KryptonPlusPlus/bss500-sheldon-reverse/hardware/bss500ap/exports/pcb_top.jpg

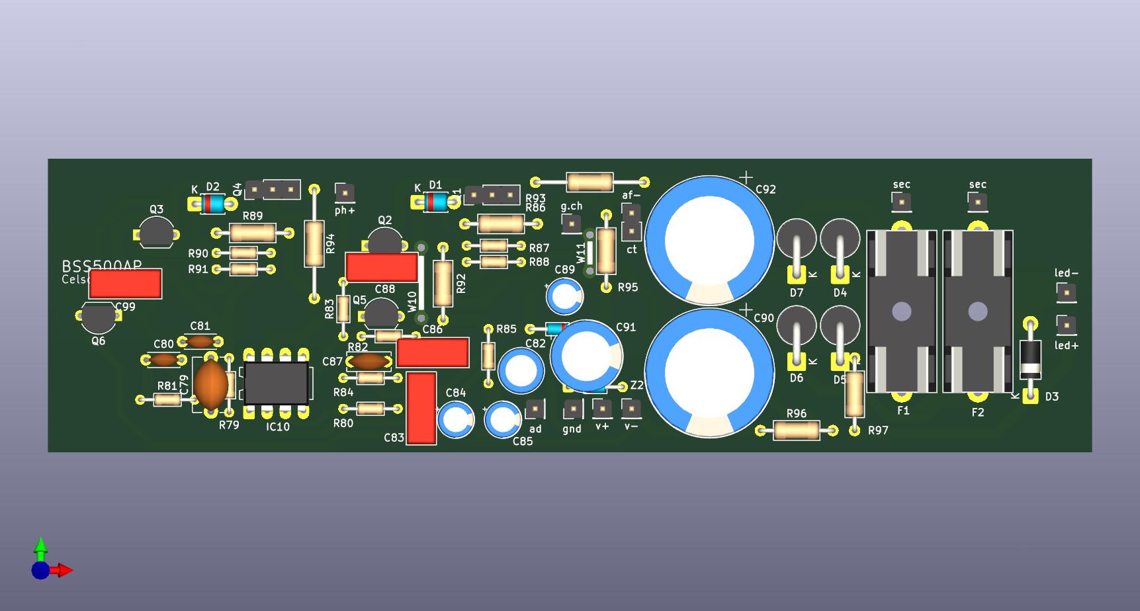
hardware/bss500ap/exports/pcb_top.jpg
