KryptonPlusPlus/bss500-sheldon-reverse/hardware/bss500ap/exports/pcb_bottom.jpg

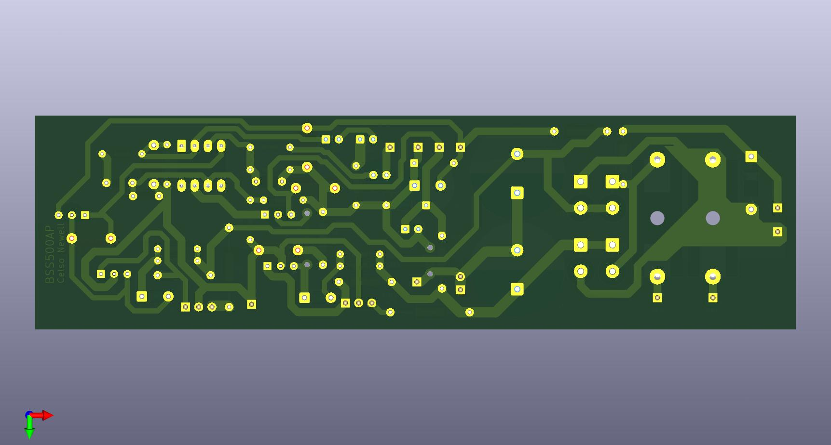
hardware/bss500ap/exports/pcb_bottom.jpg
