KryptonPlusPlus/bss500-sheldon-reverse/readme.md

# Sheldon BSS500 — Reverse Engineering

Engenharia reversa do amplificador de áudio **Sheldon BSS500**, com o objetivo de reconstruir seu circuito, documentar seus componentes e explorar possíveis modificações e melhorias.

> [!WARNING]
> **Atenção:** As informações deste repositório são baseadas na análise de um amplificador que aparenta ter passado por manutenções ou modificações anteriores. Portanto, alguns valores de componentes e conexões podem diferir do projeto original de fábrica. As informações documentadas são preliminares e devem ser verificadas antes de qualquer reprodução ou montagem do circuito.

## Objetivos

- Reconstruir o esquemático eletrônico a partir do equipamento físico.
- Identificar e documentar os componentes utilizados.
- Registrar as conexões e o funcionamento dos estágios do amplificador.
- Investigar possíveis modificações e melhorias no circuito.
- Documentar as alterações realizadas e seus efeitos no funcionamento do equipamento.

## Modificações e melhorias

Além da reconstrução do circuito, o projeto poderá incluir modificações com fins de estudo, aprimoramento e experimentação.

As possíveis alterações serão avaliadas conforme o avanço da análise do circuito original, considerando aspectos como desempenho, estabilidade, confiabilidade e qualidade de áudio.

## Status do projeto

O projeto está em desenvolvimento. A reconstrução do esquemático, a identificação dos componentes e a avaliação de possíveis modificações serão realizadas progressivamente.

## Disclaimer

Este é um projeto independente de engenharia reversa, desenvolvido para fins de estudo, experimentação e documentação. Não se trata de documentação oficial do fabricante Sheldon.
