KryptonPlusPlus/bss500-sheldon-reverse/references/pictures/bss500ap_pcb_top_side.jpeg

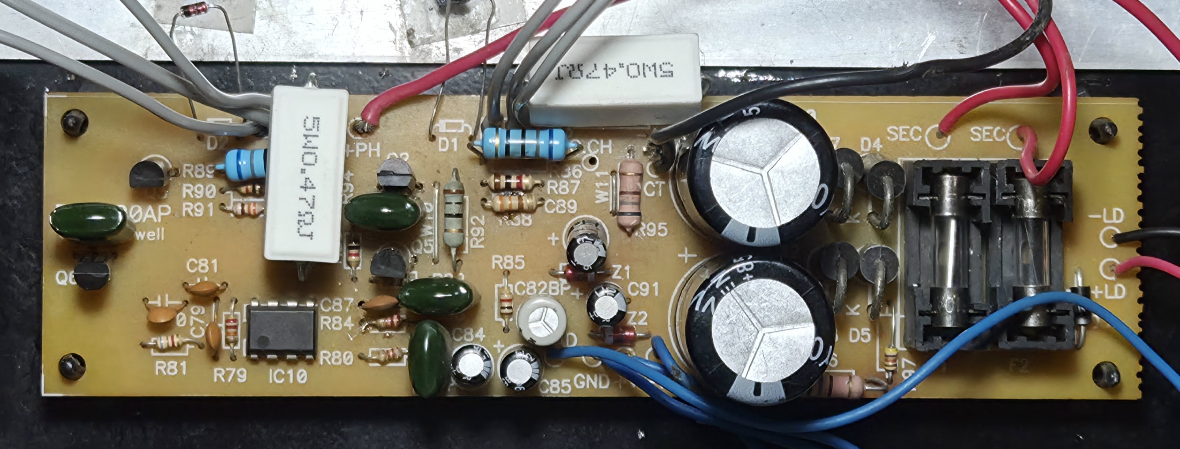
references/pictures/bss500ap_pcb_top_side.jpeg
