KryptonPlusPlus/bss500-sheldon-reverse/hardware/bss500ap/exports/pcb_layout.pdf

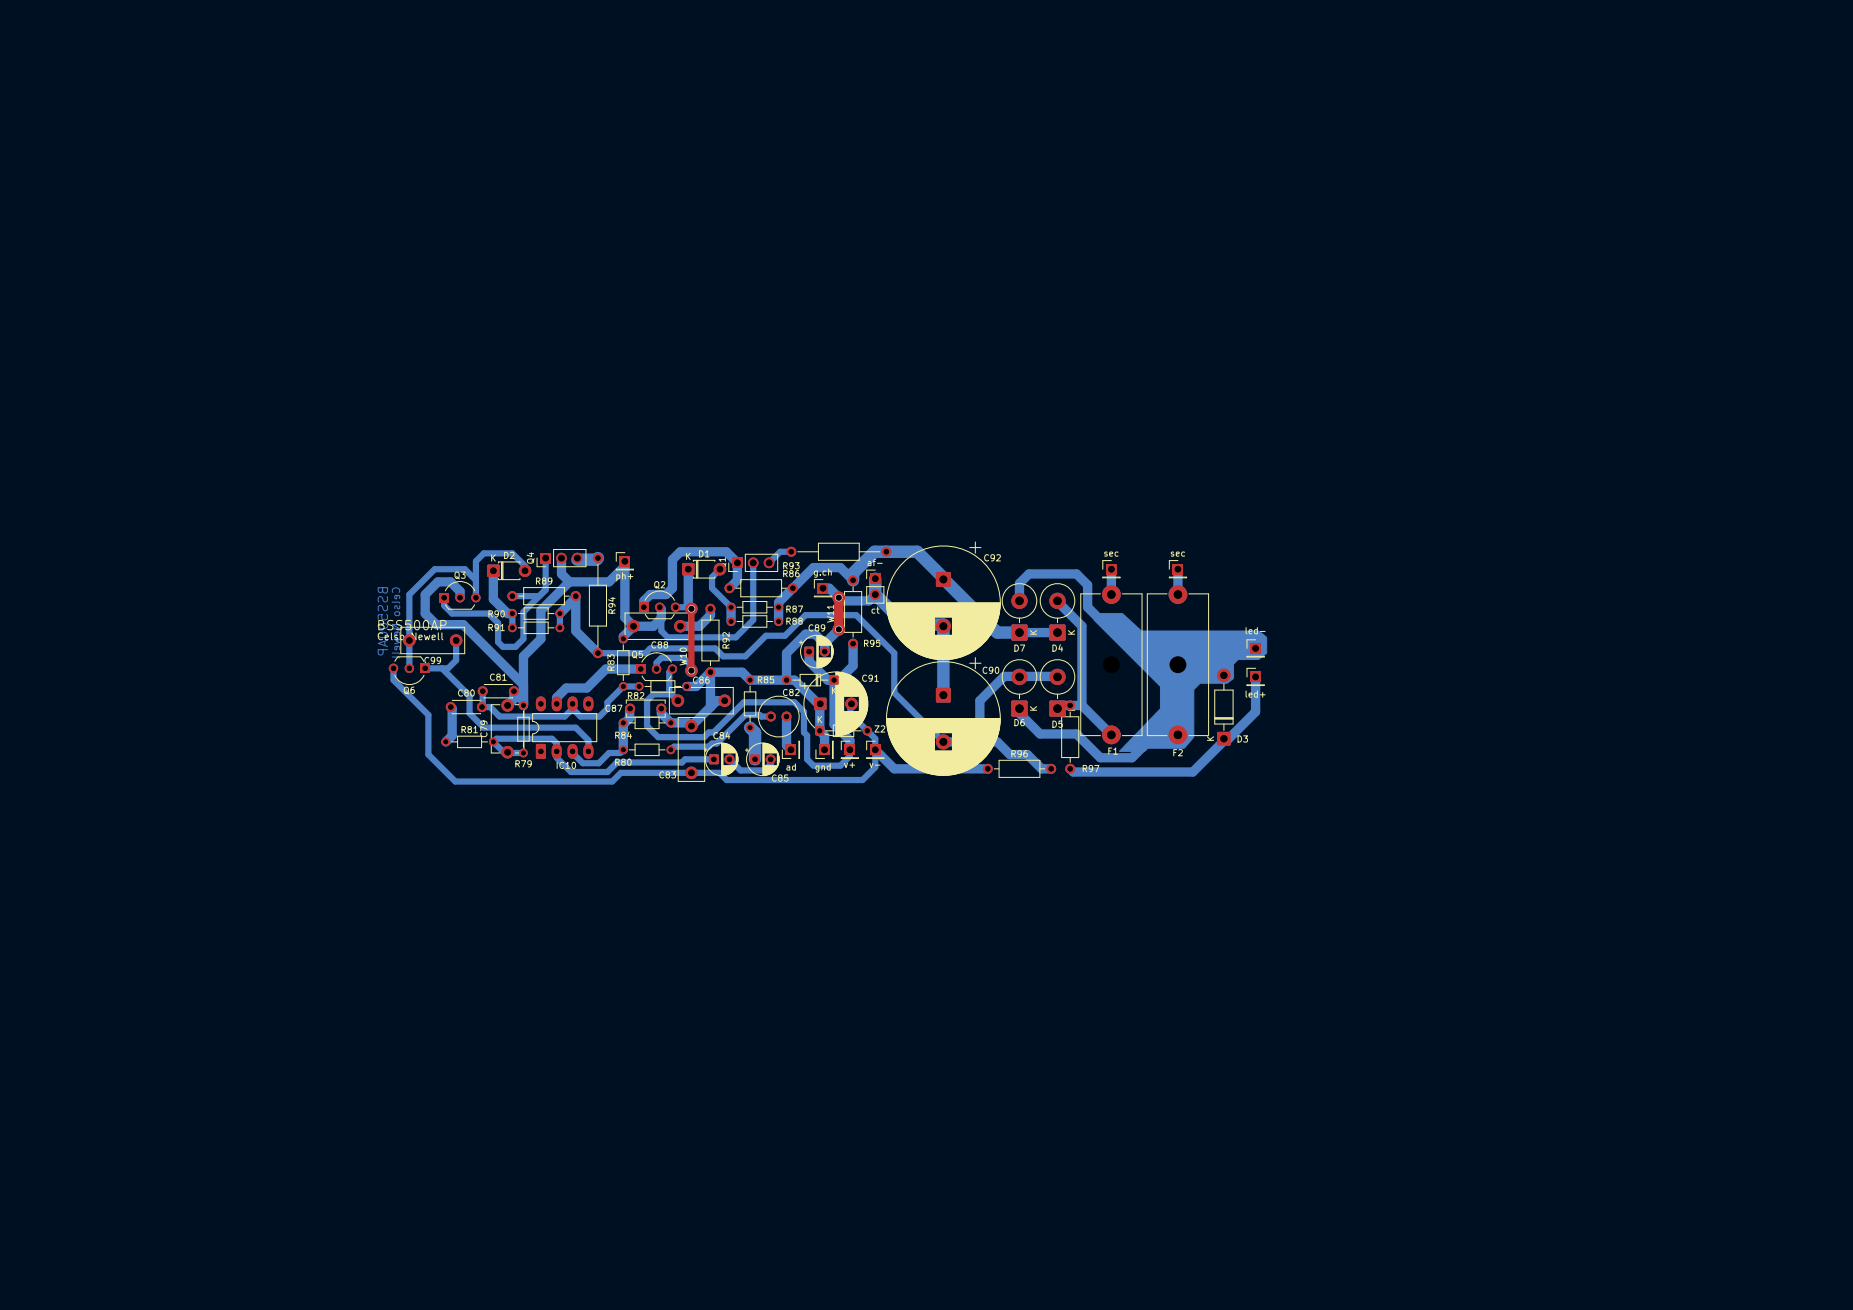
[picture p5: page 1]
