KryptonPlusPlus/bss500-sheldon-reverse/hardware/bss500ap/exports/schematic.pdf

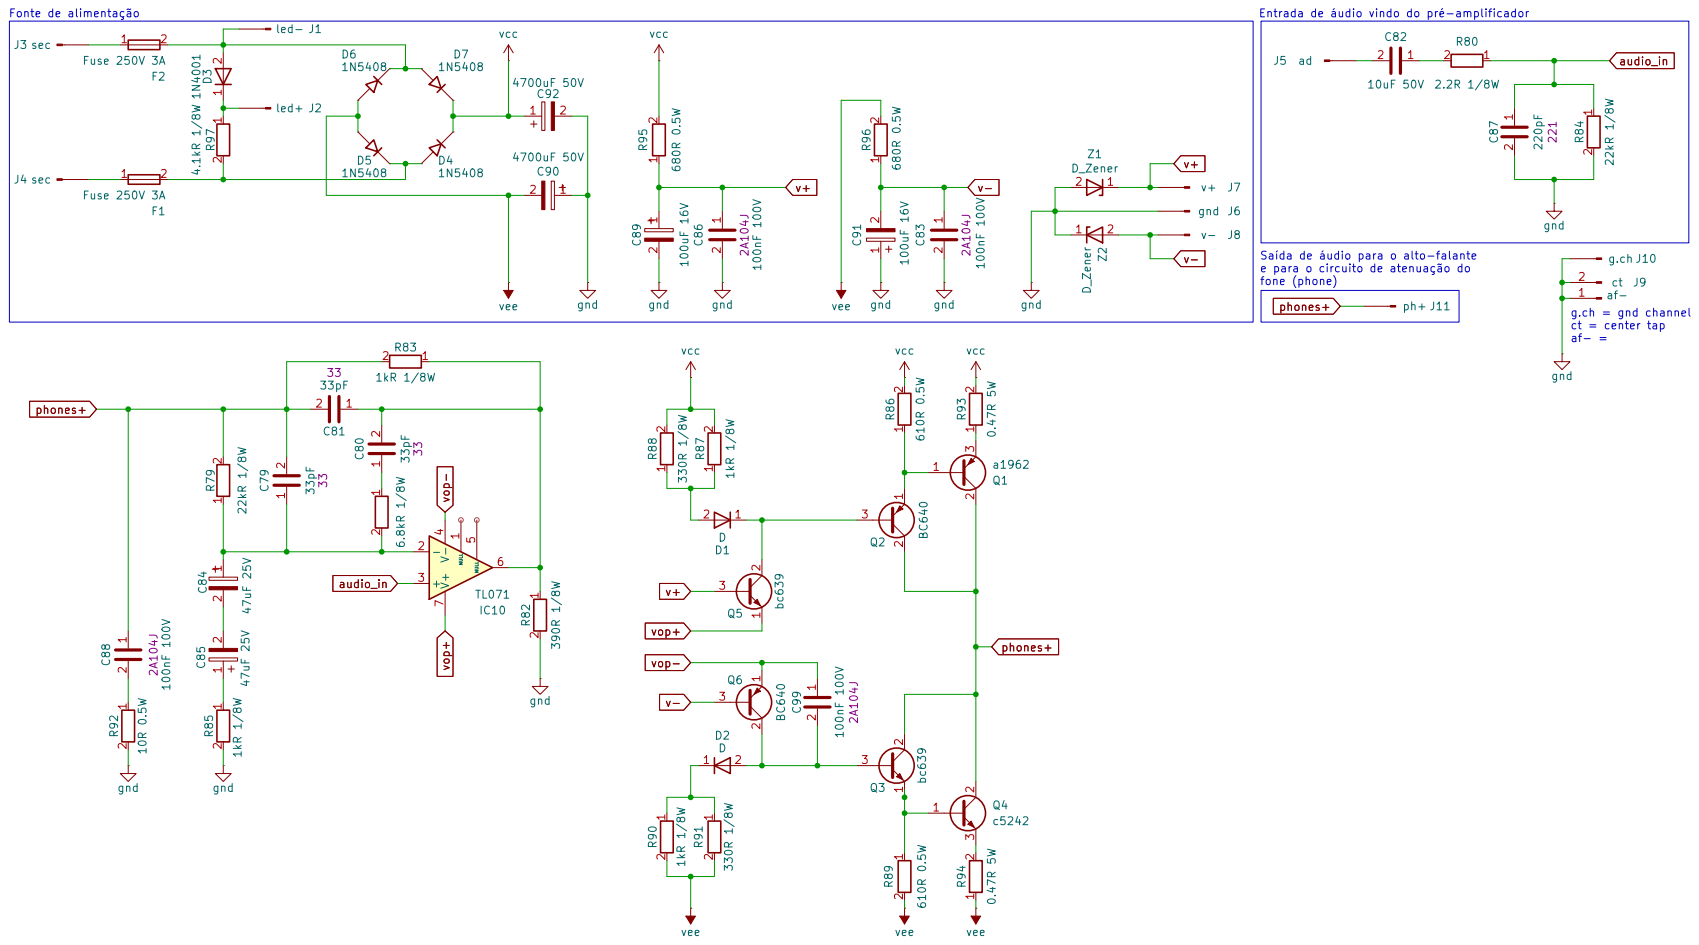
[picture p6: page 1]
