KryptonPlusPlus/bss500-sheldon-reverse/hardware/bss500ap/bss500ap.kicad_pcb

## KiCad design hardware/bss500ap/bss500ap.kicad_pcb (2026-10-28)

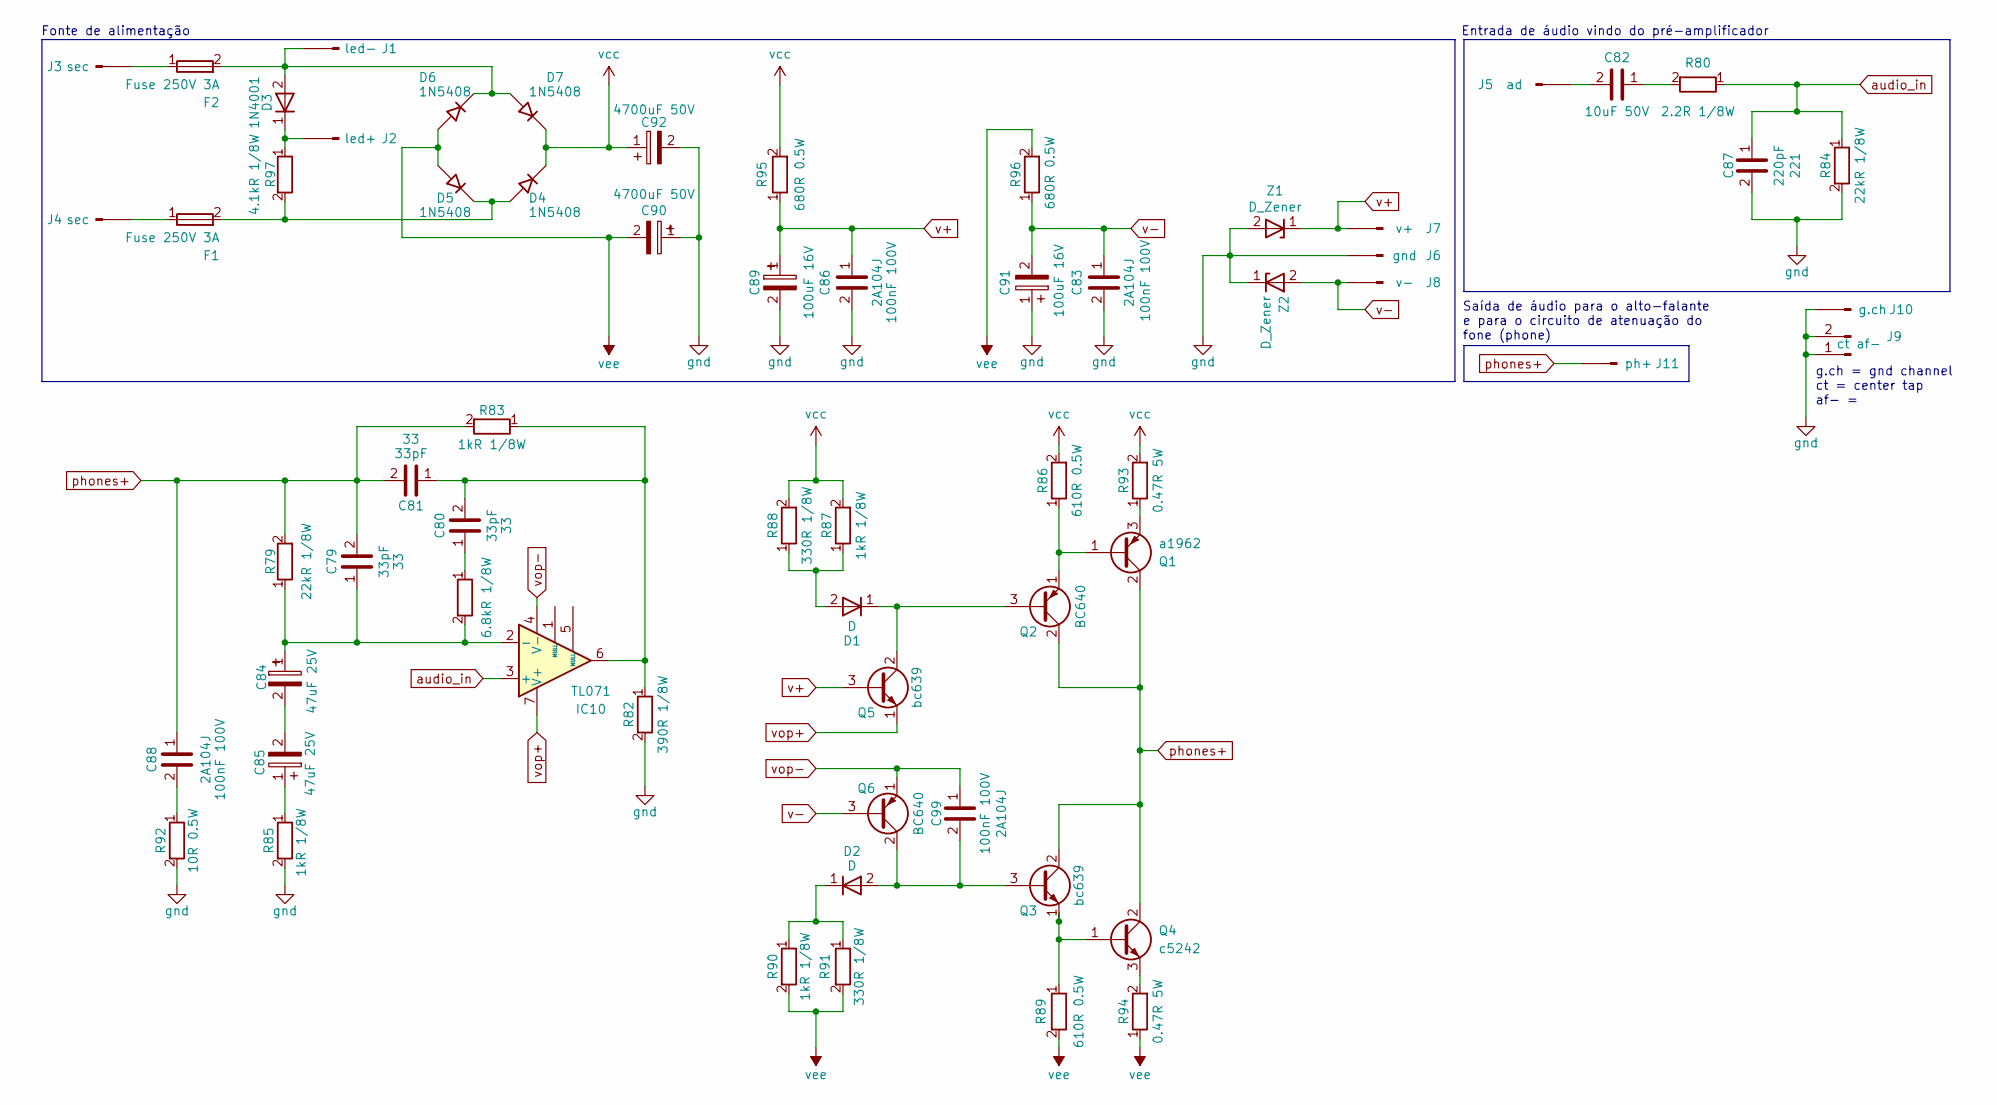
[picture p7: schematic bss500ap.kicad_sch]

Parts:
C79: 33pF; C_Disc_D7.5mm_W5.0mm_P7.50mm
C80, C81: 33pF; C_Disc_D4.3mm_W1.9mm_P5.00mm
C82: 10uF 50V; C_Radial_D6.3mm_H11.0mm_P2.50mm
C83, C86, C88, C99: 100nF 100V; C_Rect_L10.0mm_W4.0mm_P7.50mm_MKS4
C84, C85: 47uF 25V; CP_Radial_D5.0mm_P2.50mm
C87: 220pF; C_Disc_D6.0mm_W2.5mm_P5.00mm
C89: 100uF 16V; CP_Radial_D5.0mm_P2.50mm
C90, C92: 4700uF 50V; CP_Radial_D18.0mm_P7.50mm
C91: 100uF 16V; CP_Radial_D10.0mm_P5.00mm
D1, D2: D; D_T-1_P5.08mm_Horizontal
D3: 1N4001; D_DO-41_SOD81_P10.16mm_Horizontal
D4, D5, D6, D7: 1N5408; D_DO-201AE_P5.08mm_Vertical_KathodeUp
F1, F2: Fuse 250V 3A; Fuseholder_Cylinder-5x20mm_Schurter_0031_8201_Horizontal_Op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
IC10: TL071; DIP-8_W7.62mm_LongPads
J1: led-; PinHeader_1x01_P2.54mm_Vertical
J2: led+; PinHeader_1x01_P2.54mm_Vertical
J3, J4: sec; PinHeader_1x01_P2.54mm_Vertical
J5: ad; PinHeader_1x01_P2.54mm_Vertical
J6: gnd; PinHeader_1x01_P2.54mm_Vertical
J7: v+; PinHeader_1x01_P2.54mm_Vertical
J8: v-; PinHeader_1x01_P2.54mm_Vertical
J9: ct af-; PinHeader_1x02_P2.54mm_Vertical
J10: g.ch; PinHeader_1x01_P2.54mm_Vertical
J11: ph+; PinHeader_1x01_P2.54mm_Vertical
Q1: a1962; PinHeader_1x03_P2.54mm_Vertical
Q2, Q6: BC640; TO-92_Inline_Wide
Q3, Q5: bc639; TO-92_Inline_Wide
Q4: c5242; PinHeader_1x03_P2.54mm_Vertical
R79, R84: 22kR 1/8W; R_Axial_DIN0204_L3.6mm_D1.6mm_P7.62mm_Horizontal
R80: 2.2R 1/8W; R_Axial_DIN0204_L3.6mm_D1.6mm_P7.62mm_Horizontal
R81: 6.8kR 1/8W; R_Axial_DIN0204_L3.6mm_D1.6mm_P7.62mm_Horizontal
R82: 390R 1/8W; R_Axial_DIN0204_L3.6mm_D1.6mm_P7.62mm_Horizontal
R83, R85, R87, R90: 1kR 1/8W; R_Axial_DIN0204_L3.6mm_D1.6mm_P7.62mm_Horizontal
R86, R89: 610R 0.5W; R_Axial_DIN0207_L6.3mm_D2.5mm_P10.16mm_Horizontal
R88, R91: 330R 1/8W; R_Axial_DIN0204_L3.6mm_D1.6mm_P7.62mm_Horizontal
R92: 10R 0.5W; R_Axial_DIN0207_L6.3mm_D2.5mm_P10.16mm_Horizontal
R93, R94: 0.47R 5W; R_Axial_DIN0207_L6.3mm_D2.5mm_P15.24mm_Horizontal
R95, R96: 680R 0.5W; R_Axial_DIN0207_L6.3mm_D2.5mm_P10.16mm_Horizontal
R97: 4.1kR 1/8W; R_Axial_DIN0207_L6.3mm_D2.5mm_P10.16mm_Horizontal
Z1, Z2: D_Zener; D_DO-34_SOD68_P7.62mm_Horizontal

Connections:
unnamed: C80.1, R81.1
unnamed: C80.2, C81.1, IC10.6, R82.1, R83.1
unnamed: C82.1, R80.2
unnamed: C84.2, C85.2
unnamed: C85.1, R85.1
unnamed: C88.2, R92.1
unnamed: D1.2 (A), R87.1, R88.1
unnamed: D1.1 (K), Q2.3 (B), Q5.2 (C)
unnamed: C99.2, D2.2 (A), Q3.3 (B), Q6.2 (C)
unnamed: D2.1 (K), R90.1, R91.1
unnamed: D3.2 (A), D6.1 (K), D7.2 (A), F2.2, J1.1
unnamed: D3.1 (K), J2.1, R97.1
unnamed: D4.2 (A), D5.1 (K), F1.2, R97.2
unnamed: C79.1, C84.1, IC10.2 (-), R79.1, R81.2
unnamed: F2.1, J3.1
unnamed: F1.1, J4.1
unnamed: C82.2, J5.1
unnamed: Q1.1 (B), Q2.1 (E), R86.1
unnamed: Q1.3 (E), R93.1
unnamed: Q3.1 (E), Q4.1 (B), R89.1
unnamed: Q4.3 (E), R94.2
audio_in: C87.1, IC10.3 (+), R80.1, R84.1
gnd: C83.2, C86.2, C87.2, C89.2, C90.1, C91.1, C92.2, J6.1, J9.1, J9.2, J10.1, R82.2, R84.2, R85.2, R92.2, Z1.2 (A), Z2.1 (K)
phones+: C79.2, C81.2, C88.1, J11.1, Q1.2 (C), Q2.2 (C), Q3.2 (C), Q4.2 (C), R79.2, R83.2
v+: C86.1, C89.1, J7.1, Q5.3 (B), R95.1, Z1.1 (K)
v-: C83.1, C91.2, J8.1, Q6.3 (B), R96.1, Z2.2 (A)
vcc: C92.1, D4.1 (K), D7.1 (K), R86.2, R87.2, R88.2, R93.2, R95.2
vee: C90.2, D5.2 (A), D6.2 (A), R89.2, R90.2, R91.2, R94.1, R96.2
vop+: IC10.7 (V+), Q5.1 (E)
vop-: C99.1, IC10.4 (V-), Q6.1 (E)

Notes on the sheet:
Entrada de áudio vindo do pré-amplificador
Saída de áudio para o alto-falante e para o circuito de atenuação do fone (phone)
Fonte de alimentação
g.ch = gnd channel ct = center tap af- =

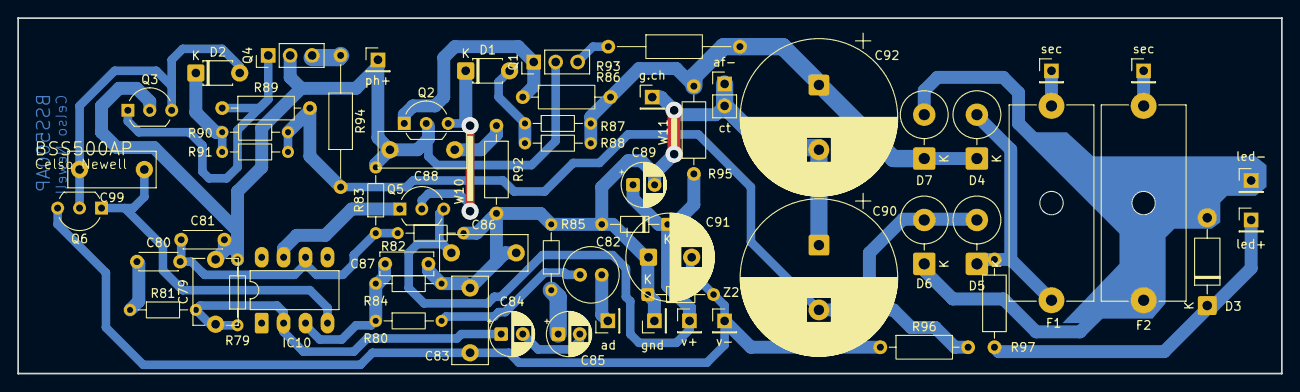
[picture p8: board bss500ap.kicad_pcb from above]

Board: 2 copper layers, 146.3 x 41.1 mm, 63 parts (0 on the bottom side), 30 nets.
