KryptonPlusPlus/bss500-sheldon-reverse/(commit log)

2026-10-28 docs(references/pictures): adiciona fotos da PCB do amplificador
2026-10-28 docs: adiciona lista de componentes da PCB do amplificador
    Adiciona a lista de componenets inicial.
    Alguns componentes ainda precisam ser identificados e
    ter seus valores e footprints confirmados.
2026-10-28 docs: adiciona diário de reparos da placa de potência
    Documenta a inspeção visual, as medições iniciais, os testes de acionamento e os sintomas observados após as intervenções.
    Registra componentes com possíveis falhas e medições que ainda precisam ser confirmadas.
2026-10-28 feat(hardware/bss500ap): adiciona projeto KiCad da placa bss500ap
    O esquemático e os componentes ainda estão em processo
    de reconstrução e validação.
    [bss500ap.kicad_pcb, bss500ap.kicad_sch]
2026-10-28 docs(hardware/bss500ap): adiciona exports do esquemático, PCB e modelo 3D
    Adiciona os arquivos exportados do projeto KiCad em, incluindo o
    esquemático em PDF, a representação da PCB e imagens do modelo 3D.
